museolab/fenetre-d-opportunite/README.md

fenetre-d-opportunite
=====================

Code du jeu "Fenêtre d'opportunité" co-designé avec OneLifeRemainsDimensions: 
Largeur 1835mm x Longueur 2830mm x Hauteur 2210mm

## Procédure de démarrage

1. Allumer le VP, puis allumer l'écran TV  (si problème avec l'écran TV, s'assurer qu'il est bien réglé sur la source "HDMI1")

2. Allumer le PC
