museolab/fenetre-d-opportunite/fiche-technique.md

#Fiche technique "Fenêtre d'Opportunité"
##Description du dispositif
Le jeu "Fenêtre d'opportunité" est constitué d'une pièce d'environ 6m2 dans laquelle le joueur évolue. Les consignes du jeu sont projetées à l'intérieur par un vidéo-projecteur. Le joureur est en contact avec les spectateurs via une webCam. Les spectateurs peuvent voir ce qu'il se pas à l'intérieur de l'espace de jeu par une webCam filmant le joueur.

Le temps d'installation et de mise en route du dispositif est d'au maximum 2 heures.

##Pré-requis d'installation
  - Encombrement
  L'emprise au sol du dispositif représente un rectangle de 1,72m x 5m, soit une surface de 8,6 m2 minimum
  Il est bien de pouvoir ciruler autour de la structure, aussi il faut ajouter 1m de passage tout autour du dispositif, soit une emprise total de 26 m2.

  - branchement
  Prévoir une prise 220v avec une puissance minimum de 1000W

  - Eclairage
  Aucun dispositif supplémentaire à ceux intégrés dans le dispositif n'est nécessaire.

##Liste des éléments du dispositif
  - 8 panneaux 87cm x 220cm
    - [ ] A1
    - [ ] A2 
    - [ ] B1 
    - [ ] B2 
    - [ ] C1 
    - [ ] C2 
    - [ ] E1 
    - [ ] E2
  - 2 retours
    - [ ] R1, 20cm x 220 cm 
    - [ ] R2, 20cm x 87 cm x 220 cm
  - [ ] 30 vis d'assemblage M8x120
  - [ ] 4 traverses hautes
  - [ ] 4 traverses basses
  - [ ] 36 vis d'assemblage M8x100
  - [ ] 66 rondelles pour vis coniques.
  - [ ] Traverse haute de l'entrée
  - [ ] Traverses de support vidéo-proj
  - [ ] 7 vis d'assemblage M8x100
  - [ ] Support de video-proj
  - [ ] 4 vis d'assemblage M8x60
  - [ ] élingue d'assurage vidéo-proj
  - [ ] support webCam intéieure
  - [ ] socle téléviseur
  - [ ] Canapé Ikéa
  - [ ] Rideau de porte d'entrée dispositif
  - [ ] 2m ou plus de passe-câble (plus selon implantation)
  - [ ] 

##Matériel électrique et infomatique
  - [ ] câble Europa vidéo-proj
  - [ ] câble VGA <-> DVI vidéo-proj <-> PC
  - [ ] 20 câbles XLR mâle/Femelle numérotés de 1 à 20.
  - [ ] PC avec le soft 'Processing' installé + VLC
  - [ ] 2 webCams Logitech USB
  - [ ] Téléviseur HD Philips
  - [ ] Câble Europa Tv
  - [ ] Télécommande Tv
  - [ ] Câble HDMI Tv <-> PC
  - [ ] 2 rallonges électrique 220v
  - [ ] Transucteur sonore
  - [ ] alimentation transucteur sonore
  - [ ] jack mâle/mâle transucteur sonore 2.5mm / 3.5mm
  - [ ] 2 projecteurs à pince pour l'éclairage intérieur 

##Matériel de montage
  - [ ] Clé alène de 5mm
  - [ ] 2 sangles à cliquets
  - [ ] petit escabeau
  - [ ] tournevis 
  - [ ] Scotch shatterton de couleur pour la scénographie.

##Matériel facultatif
  - [ ] multiprise 220v 5 entrées

##Exploitation
  - Démarrage
    - Appuyer un bref instant sur le bouton d'alumage/extinction du PC
    - Allumer le vidéo-proj
    
  - Arrêt
    - Appuyer un bref instant sur le bouton d'alumage/extinction du PC
    - Eteindre le vidéo-proj

  - Règlages
