museolab/fenetre-d-opportunite/documents/fiche-technique.md

#Fiche technique "Fenêtre d'Opportunité"
##Description du dispositif
Le jeu "Fenêtre d'opportunité" est constitué d'une pièce d'environ 6m2 dans laquelle le joueur évolue. Les consignes du jeu sont projetées à l'intérieur par un vidéo-projecteur. Le joureur est en contact avec les spectateurs via une webCam. Les spectateurs peuvent voir ce qu'il se pas à l'intérieur de l'espace de jeu par une webCam filmant le joueur.

Le temps d'installation et de mise en route du dispositif est d'au maximum 2 heures.

##Pré-requis d'installation
  - Encombrement
  L'emprise au sol du dispositif représente un rectangle de 1,72m x 5m, soit une surface de 8,6 m2 minimum
  Il est bien de pouvoir ciruler autour de la structure, aussi il faut ajouter 1m de passage tout autour du dispositif, soit une emprise total de 26 m2.

  - branchement
  Prévoir une prise 220v avec une puissance minimum de 1000W

  - Eclairage
  Aucun dispositif supplémentaire à ceux intégrés dans le dispositif n'est nécessaire.

##Liste des éléments du dispositif
  - 8 panneaux 87cm x 220cm
    - [ ] A1
    - [ ] A2 
    - [ ] B1 
    - [ ] B2 
    - [ ] C1 
    - [ ] C2 
    - [ ] E1 
    - [ ] E2
  - 2 retours
    - [ ] R1, 20cm x 220 cm 
    - [ ] R2, 20cm x 87 cm x 220 cm
  - [ ] 30 vis d'assemblage M8x120
  - [ ] 4 traverses hautes
  - [ ] 4 traverses basses
  - [ ] 36 vis d'assemblage M8x100
  - [ ] 66 rondelles pour vis coniques.
  - [ ] Traverse haute de l'entrée
  - [ ] Traverses de support vidéo-proj
  - [ ] 7 vis d'assemblage M8x100
  - [ ] Support de video-proj
  - [ ] 4 vis d'assemblage M8x60
  - [ ] élingue d'assurage vidéo-proj
  - [ ] support webCam intéieure
  - [ ] socle téléviseur
  - [ ] Canapé Ikéa
  - [ ] Rideau de porte d'entrée dispositif
  - [ ] 2m ou plus de passe-câble (plus selon implantation)
  - [ ] 

##Matériel électrique et infomatique
  - [ ] câble Europa vidéo-proj
  - [ ] câble VGA <-> DVI vidéo-proj <-> PC
  - [ ] 20 câbles XLR mâle/Femelle numérotés de 1 à 20.
  - [ ] PC avec le soft 'Processing' installé + VLC
  - [ ] 2 webCams Logitech USB
  - [ ] Téléviseur HD Philips
  - [ ] Vidéoprojecteur focale courte Epson
  - [ ] Câble Europa Tv
  - [ ] Télécommande Tv
  - [ ] Câble HDMI Tv <-> PC
  - [ ] 2 rallonges électrique 220v
  - [ ] Transucteur sonore
  - [ ] alimentation transucteur sonore
  - [ ] jack mâle/mâle transucteur sonore 2.5mm / 3.5mm
  - [ ] 2 projecteurs à pince pour l'éclairage intérieur 

##Matériel de montage
  - [ ] Clé alène de 5mm ou visseuse électrique
  - [ ] 2 sangles à cliquets
  - [ ] escabeau
  - [ ] tournevis 
  - [ ] Pied de biche 
  - [ ] Scotch shatterton de couleur pour la scénographie.

##Matériel facultatif
  - [ ] multiprise 220v 5 entrées

##Exploitation
- Démarrage du dispositif interactif "Fenêtre d'Opportunité"

 1. Alimenter le dispositif en électricité : brancher la fiche blanche dans la prise murale blanche ; celles-ci sont situées à gauche de la porte la plus proche, sous le boîtier rouge "protection incendie".
> Le vidéoprojecteur démarre automatiquement, ainsi que les néons autour de la "cage" en bois.

 2. Une fois le vidéoprojecteur en état de marche, démarrer le téléviseur avec la télécommande posée à sa gauche.
Reposer la télécommande à gauche du téléviseur, pour permettre au prochain utilisateur de ne pas avoir à la chercher.

 3. Démarrer l'ordinateur. L'ordinateur est situé en haut de la partie "caisson" de la "cage". Pour accéder à l'ordinateur, monter sur le petit escabeau blanc. Pour le démarrer, effectuer un appui court sur le bouton en façade avant (côté du boîtier de l'ordinateur opposé au câblage).

 4. À partir du moment où le bureau de l'ordinateur est affiché par le téléviseur (il faut voir "acer" écrit en blanc sur un fond vert, et la barre des tâches en bas de l'affichage, comportant trois icônes), prendre la souris posée à droite du téléviseur et aller à l'intérieur de la "cage".

Une fois à l'intérieur :
Si l'affichage du vidéoprojecteur indique "Activer Windows" sur un fond bleu, cliquer sur la case "Accéder aux paramètres de l'ordinateur". Sinon, passer à la ligne suivante.
Positionner le pointeur de la souris à l'extrémité du coin en bas à gauche de l'affichage du vidéoprojecteur pour faire apparaître l'icône représentant le bureau de l'ordinateur ("acer" écrit en blanc sur un fond vert).
Cliquer sur cette icône afin que le bureau de l'ordinateur soit également affiché en plein écran par le vidéoprojecteur, de la même façon qu'il est affiché par le téléviseur.

 5. Retourner à l'extérieur de la "cage" avec la souris. 
Sur l'affichage du téléviseur, cliquer sur l'icône "dossier" jaune, située en bas à gauche, dans la barre des tâches. 
> La fenêtre "Bibliothèques" s'ouvre sur le téléviseur.
Dans la fenêtre "Bibliothèques", cliquer sur l'icône "Bureau" située sur la gauche.
Puis suivre le chemin suivant en double-cliquant sur les différents sous-dossiers : 
FENETRE_OPPORTUNITE > bin > fenetre
Dans la fenêtre "fenetre", double-cliquer sur le fichier "fenetre.pde".
> Le logiciel "processing" démarre, sans changement d'affichage sur le téléviseur.

 6. Retourner à l'intérieur de la "cage" avec la souris.
Cliquer sur l'icône "play" (triangle noir dans cercle à fond blanc) de la fenêtre du logiciel "processing".
> Le programme "fenetre" démarre. Après quelques secondes, le vidéoprojecteur affiche le flux vidéo de la caméra dirigée vers l'extérieur de la cage, et des carrés de couleurs se superposent à l'image vue par la caméra.

 7. Retourner à l'extérieur de la "cage" avec la souris.
Fermer la fenêtre "fenetre" toujours ouverte sur le bureau de l'ordinateur, puis cliquer sur l'icône "vlc" (petit plot orange et blanc) située en bas à gauche, dans la barre des tâches.
> Le logiciel "vlc" démarre, s'affichant en plein écran sur le téléviseur

Dans l'onglet "Média" du menu en haut à gauche, cliquer sur "ouvrir un périphérique de capture".
> La fenêtre "Ouvrir un média" s'ouvre au centre de l'affichage.

Dans le cadre "Sélection de périphérique", cliquer sur la première case "Prédéfini(e)" (celle du haut).
Dans le menu déroulant qui s'affiche, cliquer sur le dernier choix, "Logitech HD Webcam C310 #1".
Cliquer ensuite sur la case "Lire" située en bas de la fenêtre.
> Après quelques secondes, le téléviseur affiche le flux vidéo de la caméra dirigée vers l'intérieur de la cage.

Dans l'onglet "Vidéo" du menu en  haut à gauche, cliquer sur "Plein écran".
> Les éléments de l'interface utilisateur disparaissent de l'affichage du téléviseur et l'image du flux vidéo s'agrandit.
Reposer la souris à droite du téléviseur, pour permettre au prochain utilisateur de ne pas avoir à la chercher.

 8. Pour activer le son, effectuer un appui court sur le bouton central du transducteur sonore. Le transducteur sonore (un petit cube noir) est situé en haut de la partie "caisson" de la "cage", à côté de l'ordinateur.

Le démarrage du dispositif interactif est terminé. A noter : le dispositif peut être utilisé avec ou sans le son.

- Extinction du dispositif interactif "Fenêtre d'Opportunité"

 1. Si le son est activé, pour le désactiver il suffit d'effectuer un appui court sur le bouton central du transducteur sonore. Le transducteur sonore (un petit cube noir) est situé en haut de la partie "caisson" de la "cage", à côté de l'ordinateur.

 2. Avec la souris posée à droite du téléviseur, effectuer un clic droit n'importe où sur l'affichage du téléviseur. 
Dans le menu qui apparaît, cliquer sur "Quitter".
> La fenêtre du logiciel "vlc" se ferme, le téléviseur affiche à présent le bureau de l'ordinateur.

 3. Effectuer un clic droit sur l'icône "P" située en bas à gauche, dans la barre des tâches.
Dans le menu qui apparaît, cliquer sur "Fermer la fenêtre".
 > Le logiciel "processing" s'éteint en fermant le programme "fenetre", le vidéoprojecteur (à l'intérieur de la "cage" en bois) affiche à présent le bureau de l'ordinateur.
 
 4. Positionner le pointeur de la souris à l'extrémité du coin en bas à droite de l'affichage du téléviseur pour faire apparaître cinq icônes blanches permettant, entre autres, d'éteindre l'ordinateur.
Cliquer sur l'icône "Paramètres", puis sur l'icône "Marche/Arrêt" qui apparaît en bas.
Dans le menu déroulant, cliquer sur "Arrêter".
Reposer la souris à droite du téléviseur, pour permettre au prochain utilisateur de ne pas avoir à la chercher.

 5. Une fois l'ordinateur éteint, arrêter le téléviseur avec la télécommande posée à sa gauche.
Reposer la télécommande à gauche du téléviseur, pour permettre au prochain utilisateur de ne pas avoir à la chercher.

 6. Arrêter le vidéoprojecteur en appuyant délicatement (pour ne pas déplacer le vidéoprojecteur), deux fois de suite, sur le bouton portant l'icône orange "Marche/Arrêt".

 7. Couper l'alimentation électrique du dispositif : débrancher la fiche blanche de la prise murale blanche ; celles-ci sont situées à gauche de la porte la plus proche, sous le boîtier rouge "protection incendie".

L'extinction du dispositif interactif est terminée.
