museolab/fenetre-d-opportunite/documents/plan-cube2.pdf

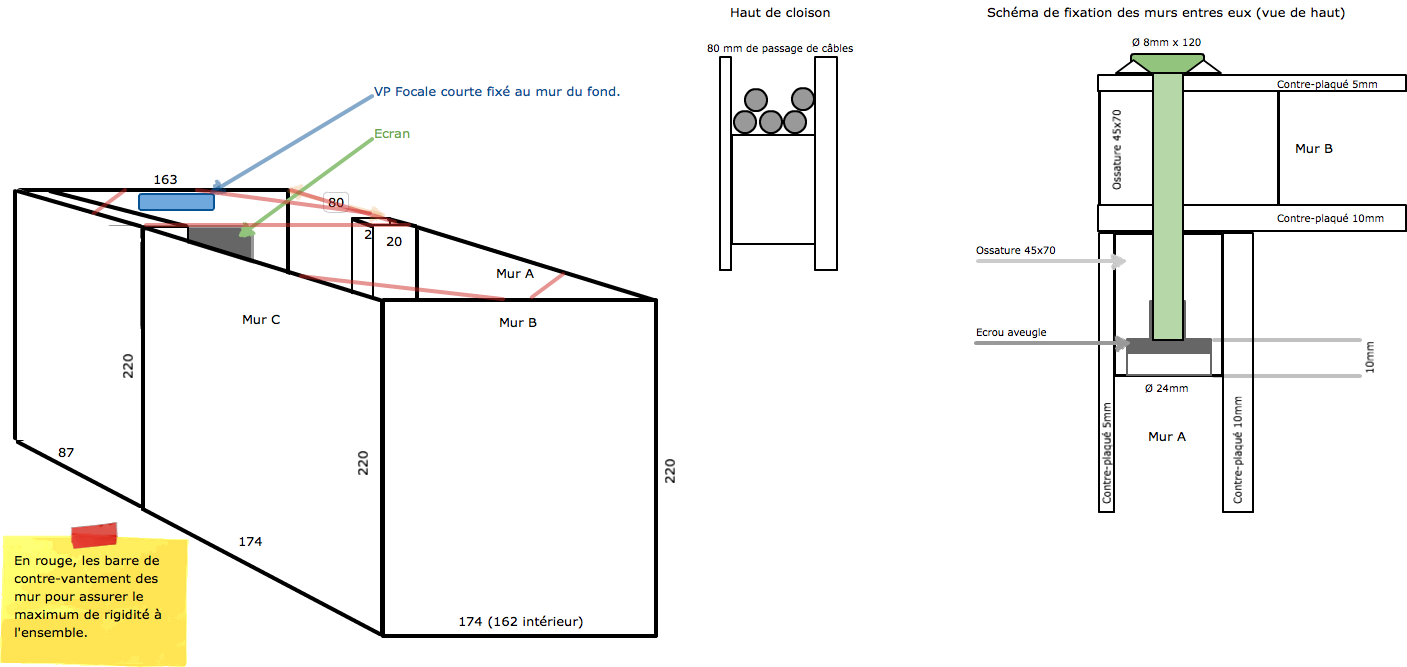
[picture p1: page 1]
