museolab/fenetre-d-opportunite/documents/plan-realisation-cube.pdf

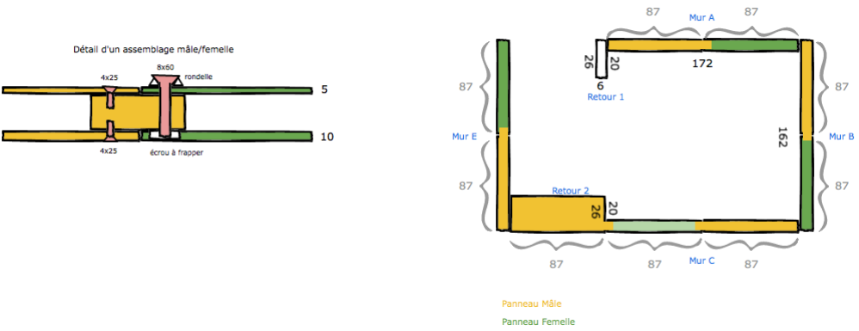
[picture p2: figure]
