museolab/fenetre-d-opportunite/documents/disposition-boutons/FenetreOpportunite_Boite.jpg

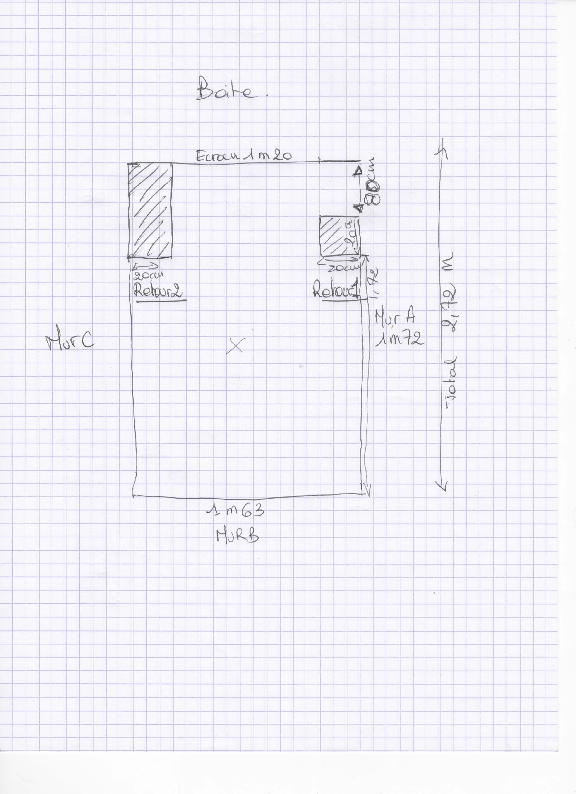
documents/disposition-boutons/FenetreOpportunite_Boite.jpg
