museolab/fenetre-d-opportunite/documents/disposition-boutons/FenetreOpportunite_MurA.jpg

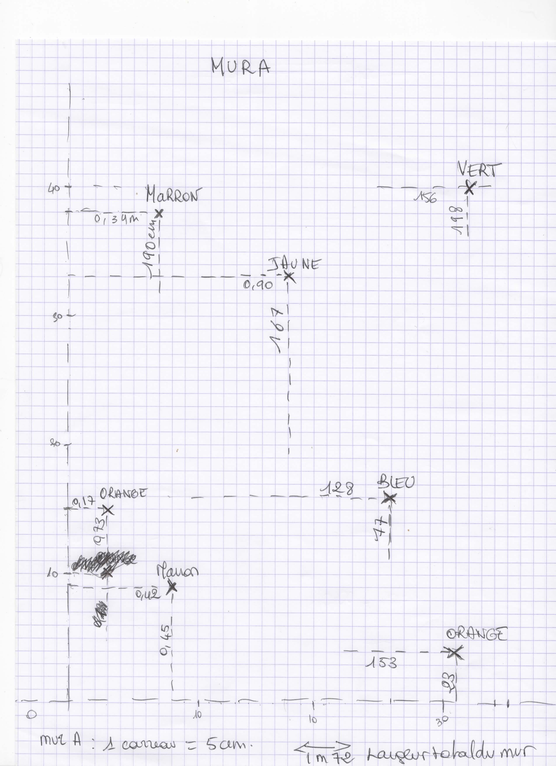
documents/disposition-boutons/FenetreOpportunite_MurA.jpg
