museolab/fenetre-d-opportunite/documents/disposition-boutons/FenetreOpportunite_MurB.jpg

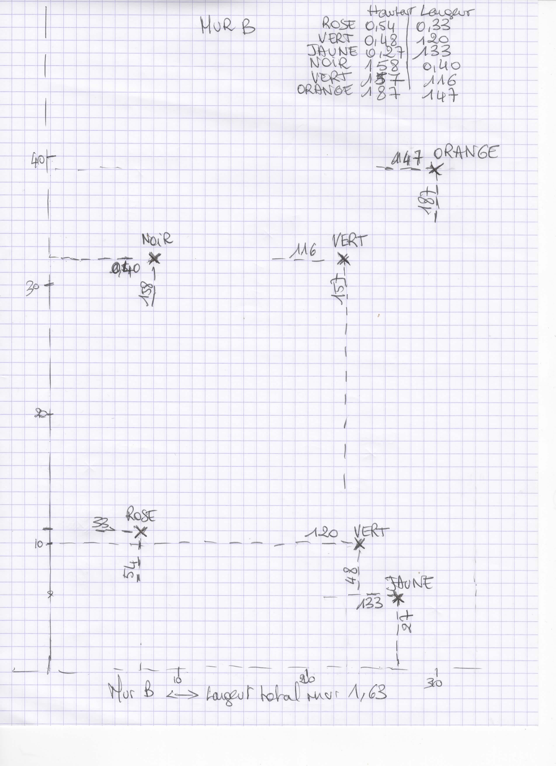
documents/disposition-boutons/FenetreOpportunite_MurB.jpg
