museolab/fenetre-d-opportunite/documents/disposition-boutons/FenetreOpportunite_MurC.jpg

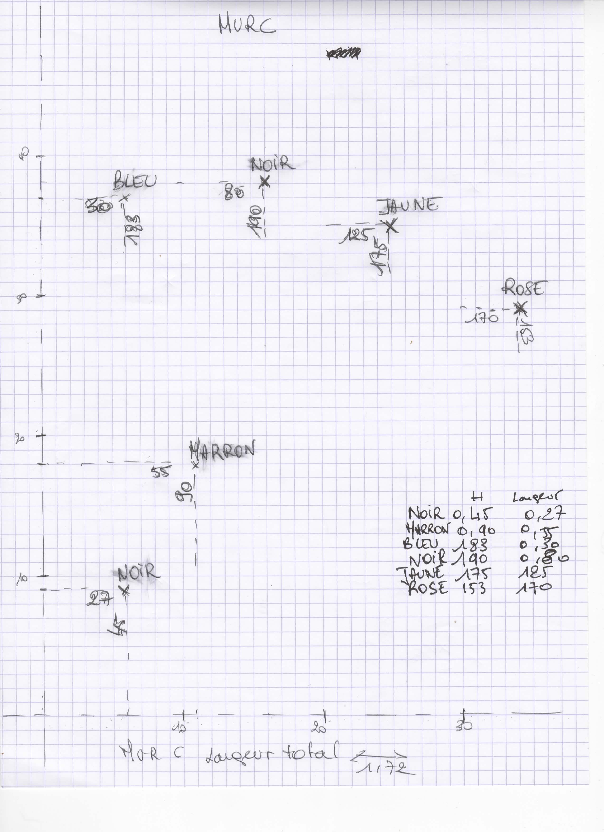
documents/disposition-boutons/FenetreOpportunite_MurC.jpg
