museolab/fenetre-d-opportunite/documents/disposition-boutons/FenetreOpportunite_Recap&Retours.jpg

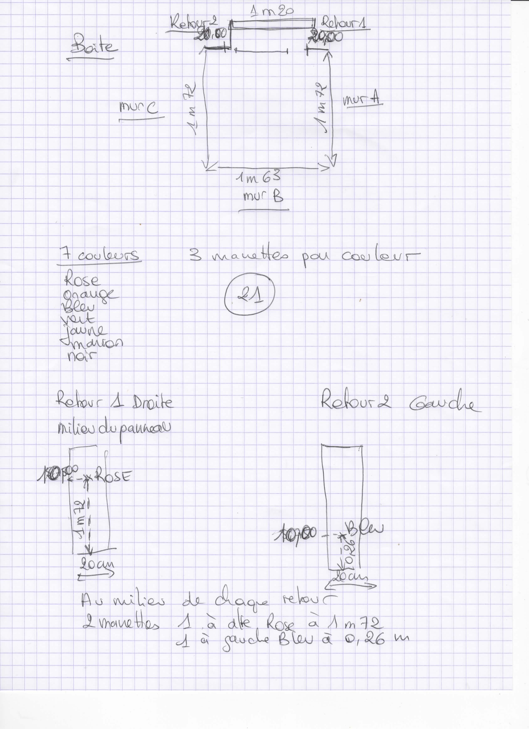
documents/disposition-boutons/FenetreOpportunite_Recap&Retours.jpg
