museolab/fenetre-d-opportunite/documents/debit-bois-cube2.ods

Sheet: débit de bois et fournitures
 |  | Ossature Larg. | 4,5 | cm
 |  | Ossature Long. | 7 | cm
 |  | Parement intérieur | 1 | cm
 |  | parement extérieur | 0,5 | cm
 |  | épaisseur cloison | 6 | cm
 |  | Densité ossature | 450 | kg/m3
 |  | Densité CP | 500 | kg/m3
Ensemble | Pièce/usage | Matériaux | mesure | unité | quantité | total | Volume (m3) | Poids (kg) | Surface en m2
Demi panneau Mâle | montant vertical | 45x70 | 2,02 | ml | 2 | 16,16 | 0,012726 | 5,7267
 | montant vertical d'assemblage | 45x70 | 2,02 | ml | 1 | 8,08 | 0,006363 | 2,86335
 | montant horizontal | 45x70 | 0,87 | ml | 2 | 6,96 | 0,005481 | 2,46645
 | panneau intérieur | CP 10mm 87x220 | 1 | unité | 1 | 4 | 0,01914 | 9,57 | 7,656
 | panneau extérieur | CP 5mm 87x220 | 1 | unité | 1 | 4 | 0,00957 | 4,785 | 7,656
 |  | écrous à frapper M8 | 1 | unité | 16 | 64
 | Fixation panneau intérieur | vis bois 4x25 | 1 | unité | 43 | 172
 | Fixation panneau extérieur | vis bois 4x25 | 1 | unité | 43 | 172
 | Raccordement d'angle | vis M8 x 12 | 1 | unité | 6 | 24
 |  |  |  |  |  |  | s/tot quicaillerie | 0,5
 |  |  |  |  | Quantité pour cet ensemble : | 4 | Total par élément | 26
Demi panneau Femelle | montant vertical | 45x70 | 2,02 | ml | 3 | 24,24 | 0,019089 | 8,59005
 | montant horizontal | 45x70 | 0,87 | ml | 2 | 6,96 | 0,005481 | 2,46645
 | panneau intérieur | CP 10mm 87x220 | 1 | unité | 1 | 4 | 0,01914 | 9,57 | 7,656
 | panneau extérieur | CP 5mm 87x220 | 1 | unité | 1 | 4 | 0,00957 | 4,785 | 7,656
 |  | écrous à frapper M8 | 1 | unité | 10 | 40
 | Raccordement d'angle | vis M8 x 12 | 1 | unité | 6 | 24
 | Fixation panneau intérieur | vis bois 4x25 | 1 | unité | 43 | 172
 | Fixation panneau extérieur | vis bois 4x25 | 1 | unité | 43 | 172
 | Raccordement Male/Femelle | vis M8 x 5 | 1 | unité | 6 | 24 | s/tot quicaillerie | 0,5
 |  |  |  |  | Quantité pour cet ensemble : | 4 | Total par élément | 26
Retour 1 26x6 | montant vertical | 45x70 | 2,02 | ml | 2 | 4,04 | 0,012726 | 5,7267
 | panneau d'habillage | CP 10mm 26x220 | 1 | unité | 1 | 1 | 0,01914 | 9,57 | 0,572
 |  | CP 5mm 26x220 | 1 | unité | 1 | 1 | 0,00286 | 1,43 | 0,572
 |  | écrous à frapper M8 | 1 | unité | 6 | 6
 |  | vis M8 x 12 | 1 | unité | 6 | 6
 | Fixation panneau | vis bois 4x25 | 1 | unité | 25 | 25 | s/tot quicaillerie | 0,3
 |  |  |  |  | Quantité pour cet ensemble : | 1 | Total par élément | 17
Retour 2 26x87 | montant vertical | 45x70 | 2,02 | ml | 4 | 8,08 | 0,025452 | 11,4534
 | montant horizontal | 45x70 | 0,87 | ml | 4 | 3,48 | 0,010962 | 4,9329
 | panneau d'habillage | CP 10mm 26x220 | 1 | unité | 1 | 1 | 0,01914 | 9,57 | 0,572
 | panneau d'habillage | CP 10mm 87x220 | 1 | unité | 1 | 1 | 0,01914 | 9,57 | 1,914
 |  | CP 5mm 26x220 | 1 | unité | 1 | 1 | 0,00286 | 1,43 | 0,572
 |  | CP 5mm 87x220 | 1 | unité | 1 | 1 | 0,00957 | 4,785 | 1,914
 |  | écrous à frapper M8 | 1 | unité | 12 | 12
 |  | vis M8 x 12 | 1 | unité | 12 | 12
 | Fixation panneau | vis bois 4x25 | 1 | unité | 100 | 100 | s/tot quicaillerie | 0,5
 |  |  |  |  | Quantité pour cet ensemble : | 1 | Total par élément | 42
Ceinture | longueur | 45x70 | 1,72 | ml | 2 | 6,88 | 0,010836 | 4,8762
 | largeur | 45x70 | 1,62 | ml | 2 | 6,48 | 0,010206 | 4,5927
 | Fixation ceinture | vis M8 x 10 | 1 | unité | 8 | 16
 |  |  |  |  | Quantité pour cet ensemble : | 2 | Total par élément | 9
Contre-ventement | À 45° | 45x70 | 1 | ml | 4 | 4 | 0,0126 | 5,67
 | Dessus entrée | 45x70 | 1,2 | ml | 1 | 1,2 | 0,00378 | 1,701
 | espace de jeux | 45x70 | 1,62 | ml | 1 | 1,62 | 0,005103 | 2,29635
 |  | écrous à frapper M8 | 1 | unité | 16 | 16
 | Fixation ceinture | vis M8 x 10 | 1 | unité | 16 | 16 | s/tot quicaillerie | 0,2
 |  |  |  |  | Quantité pour cet ensemble : | 1 | Total par élément | 10 | 36,74 | m2
Divers |  | medium 3mm | 1 |  | 0 | 0
 |  |  |  |  |  | 0
 |  |  |  |  |  | 0
 |  |  |  |  |  | 0
 |  |  |  |  |  | 0
 |  |  |  |  |  | 0
 |  |  |  |  |  | 0
 |  |  |  |  | Quantité pour cet ensemble : | 1 |  | 295
 |  | 45x70 | 98,18 | ml
 |  | CP 10mm 87x220 | 9
 |  | CP 5mm 87x220 | 9
 |  | CP 10mm 26x220 | 2
 |  | CP 5mm 26x220 | 2
 |  | medium 3mm 450x300 | 20

Sheet: Decoupe
L voulues | nb de morceaux | reste à couper | Longueur lambourde |  | 4,5 | ml en 45x70
1,98 | 20 | 0
0,87 | 20 | 0
1,72 | 4 | 0
1 | 4 | 0
1,2 | 1 | 0
1,62 | 5 | 0
Lambourde | L lambourde | L voulue | nb morceaux | Nb de restes | L. reste |  |  | L voulues | nb de morceaux | reste à couper
1 | 4,5 | 1,98 | 2 | 1 | 0,54 |  |  | 1,98 | 20 | 0
2 | 4,5 | 1,98 | 2 | 1 | 0,54 |  |  | 0,87 | 20 | 0
3 | 4,5 | 1,98 | 2 | 1 | 0,54 |  |  | 1,72 | 4 | 0
4 | 4,5 | 1,98 | 2 | 1 | 0,54 |  |  | 1 | 4 | 0
5 | 4,5 | 1,98 | 2 | 1 | 0,54 |  |  | 1,2 | 1 | 0
6 | 4,5 | 1,98 | 2 | 1 | 0,54 |  |  | 1,62 | 5 | 0
7 | 4,5 | 1,98 | 2 | 1 | 0,54
8 | 4,5 | 1,98 | 2 | 1 | 0,54
9 | 4,5 | 1,98 | 2 | 1 | 0,54 |  | Lambourde 1,2,3,et 4 |  | 4,5 | m
10 | 4,5 | 1,98 | 2 | 1 | 0,54 |  |  | 0,87 | 3,63 | 4
11 | 4,5 | 0,87 | 5 | 1 | 0,15 |  |  | 0,87 | 2,76 | 4
12 | 4,5 | 0,87 | 5 | 1 | 0,15 |  |  | 1 | 1,76 | 4
13 | 4,5 | 0,87 | 5 | 1 | 0,15 |  |  | 1,72 | 0,04 | 4
14 | 4,5 | 0,87 | 5 | 1 | 0,15
15 | 4,5 | 1,72 | 2 | 1 | 1,06 |  | Lambourde 5 |  | 4,5 | m
16 | 4,5 | 1,72 | 2 | 1 | 1,06 |  |  | 1,62 | 2,88 | 1
17 | 4,5 | 1,62 | 2 | 1 | 1,26 |  |  | 1,62 | 1,26 | 1
18 | 4,5 | 1,62 | 2 | 1 | 1,26 |  |  | 1,2 | 0,06 | 1
19 | 4,5 | 1,62 | 1 | 1 | 2,88
20 | 1,26 | 1,2 | 1 | 1 | 0,06 |  | Lambourde 6,7, et 8 |  | 4,5 | m
21 | 1,06 | 1 | 1 | 1 | 0,06 |  |  | 1,62 | 2,88 | 3
22 | 1,06 | 1 | 1 | 1 | 0,06 |  |  | 0,87 | 2,01 | 3
23 | 2,88 | 1 | 2 | 1 | 0,88 |  |  | 0,87 | 1,14 | 3
 |  |  |  |  |  |  |  | 0,87 | 0,27 | 3
 |  |  |  |  |  |  | Lambourde 9 |  | 4,5 | m
total L brutes | 19 | 85,5 |  |  | 8,32 |  |  | 0,87 | 3,63 | 1
Marge | 1 |  |  |  |  |  |  | 0,87 | 2,76 | 1
Remplacement |  |  |  |  |  |  |  | 0,87 | 1,89 | 1
des 4x10
en 4x12 (2x6) | 4 |  |  |  |  |  | Lambourde 10 à 19 |  | 4,5 | m
 |  |  |  |  |  |  |  | 1,98 | 2,52 | 10
 | 24 |  |  |  |  |  |  | 1,98 | 0,54 | 10
 |  |  |  |  |  |  |  |  |  |  | restes
 |  |  |  |  |  |  | total L brutes |  |  | 19 | 8,32
