museolab/fenetre-d-opportunite/(commit log)

2013-10-22 Create fiche-technique.md
    ajout du plan de la fiche technique
2013-10-22 Première version de la fiche technique.
    Description du dispositif, ses éléments, son matériel électrique et informatique.
2013-12-02 Update fiche-technique.md
    procédure de démarrage et d'arrêt du dispositif.
2014-02-10 ajout documentation, plans, video
    [chiffrage.ods, debit-bois-cube2.ods]
